JJoeNapoli/SmartGlove/HARDWARE/Step_file/finger_version2_asm.stp

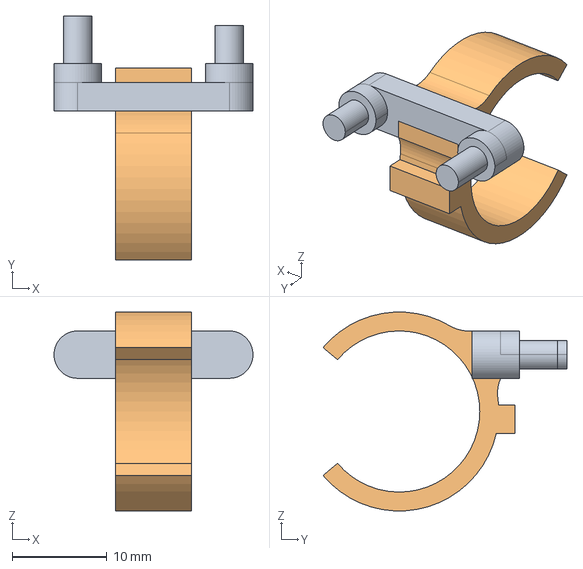
[picture p6: CAD file, 2019-07-23]
HARDWARE/Step_file/finger_version2_asm.stp
21.0 x 25.7 x 21.0 mm
FINGER_PZ1
ANELLO
