JJoeNapoli/SmartGlove/HARDWARE/stl_file/2pz_finger_v2.stl

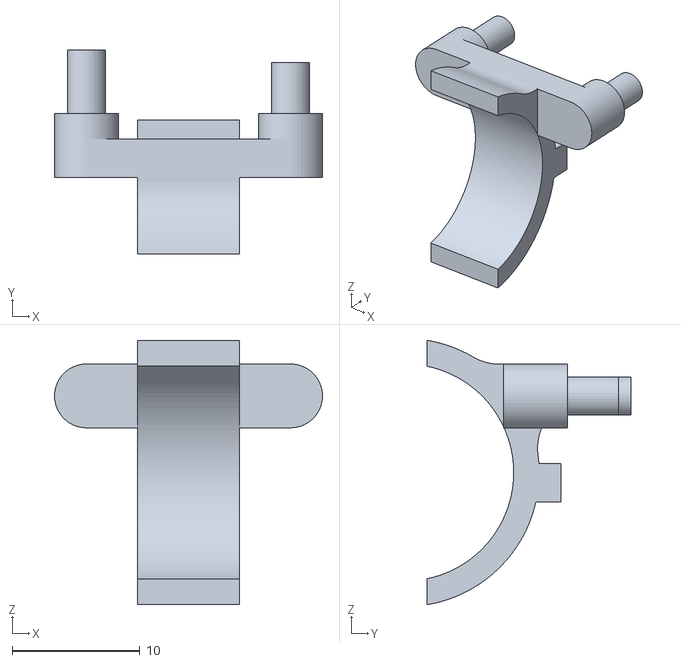
[picture p7: CAD file, 2019-07-23]
HARDWARE/stl_file/2pz_finger_v2.stl
21.0 x 16.0 x 20.7
