JJoeNapoli/SmartGlove/HARDWARE/Step_file/back_hand_support.stp

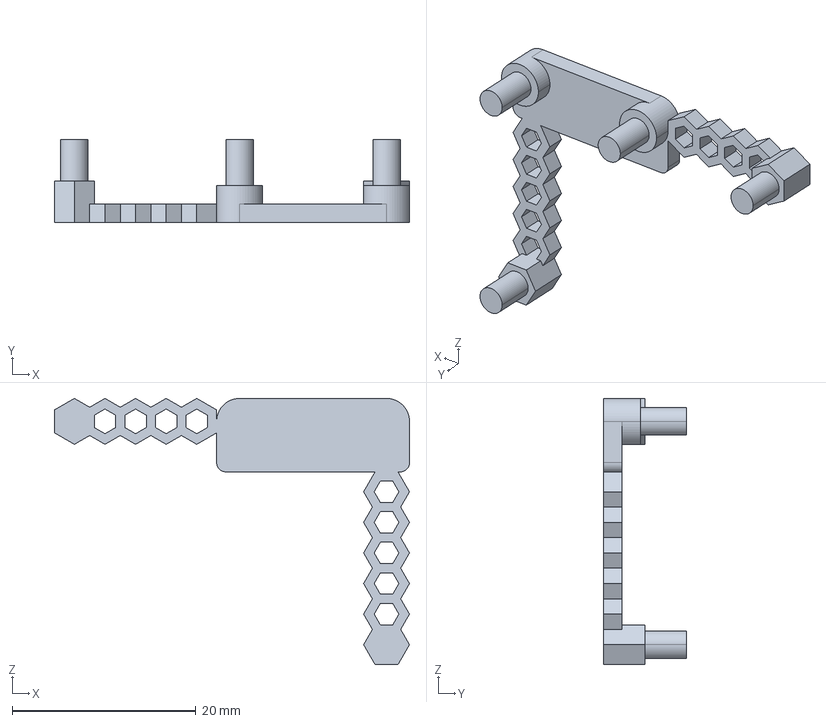
[picture p8: CAD file, 2019-07-23]
HARDWARE/Step_file/back_hand_support.stp
38.7 x 9.00 x 29.0 mm
