JJoeNapoli/SmartGlove/HARDWARE/stl_file/Hand_mount_modified.stl

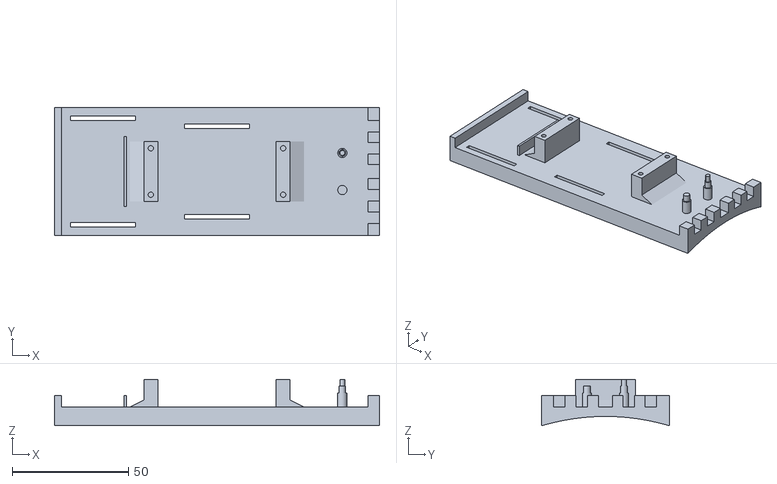
[picture p9: CAD file, 2019-07-23]
HARDWARE/stl_file/Hand_mount_modified.stl
140.0 x 55.0 x 20.0
