JJoeNapoli/SmartGlove/HARDWARE/stl_file/2pz_finger.stl

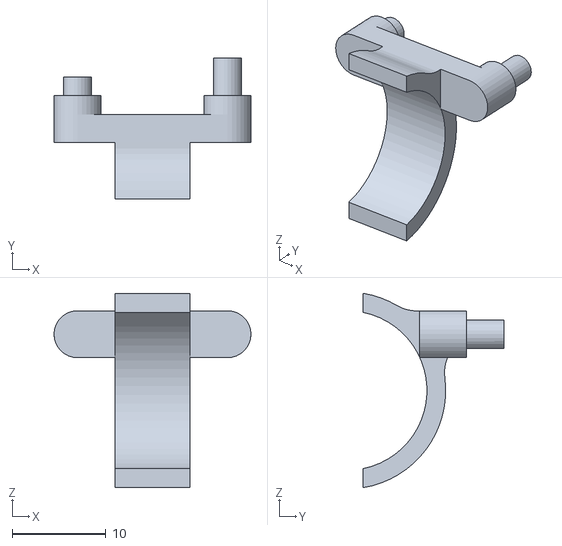
[picture p10: CAD file, 2019-07-23]
HARDWARE/stl_file/2pz_finger.stl
21.0 x 15.0 x 20.7
