JJoeNapoli/SmartGlove/(list of files, cad)

Other CAD files:
HARDWARE/Step_file/Hand_mount_STEPFILE.stp
HARDWARE/Step_file/finger_version1_asm.stp
HARDWARE/stl_file/back_hand_support.stl
